LightWave-HQ/Hardware/1ED44175N01BXTSA1/1ED44175N01BXTSA1.stp

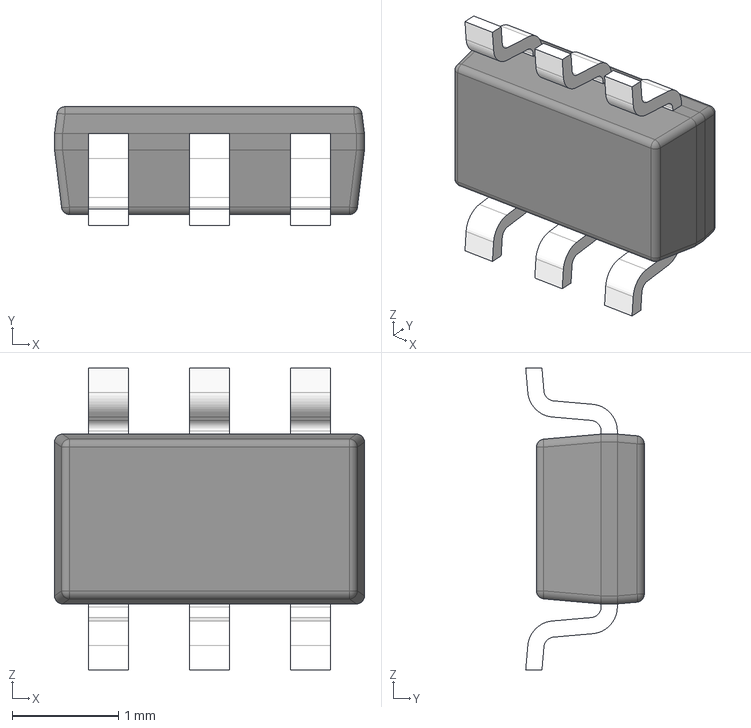
[picture p1: CAD file, 2024-12-27]
1ED44175N01BXTSA1/1ED44175N01BXTSA1.stp
2.92 x 1.12 x 2.84 mm
BODY_MF06A
LEAD_MF06A x 6
