LightWave-HQ/Hardware/SRN8040 Inductor/SRN8040-101M.STEP

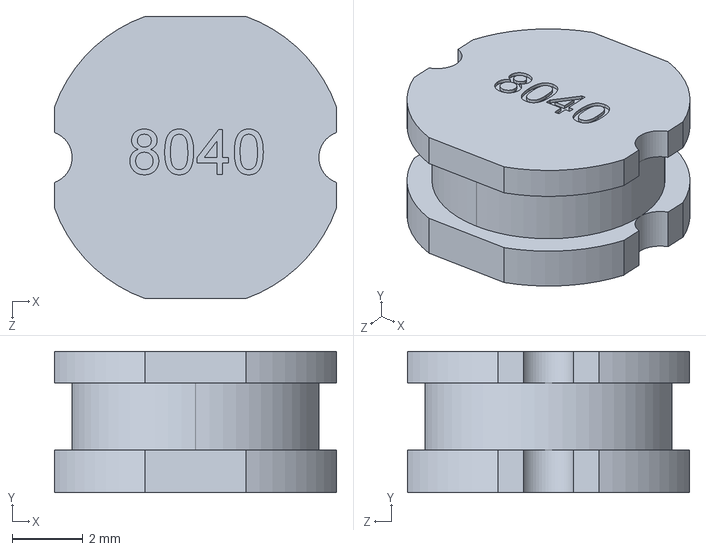
[picture p2: CAD file, 2025-01-21]
SRN8040 Inductor/SRN8040-101M.STEP
8.00 x 4.01 x 8.00 mm
