LightWave-HQ/Hardware/Led-Controller.kicad_pcb

## KiCad design Led-Controller.kicad_pcb (2025-02-26)

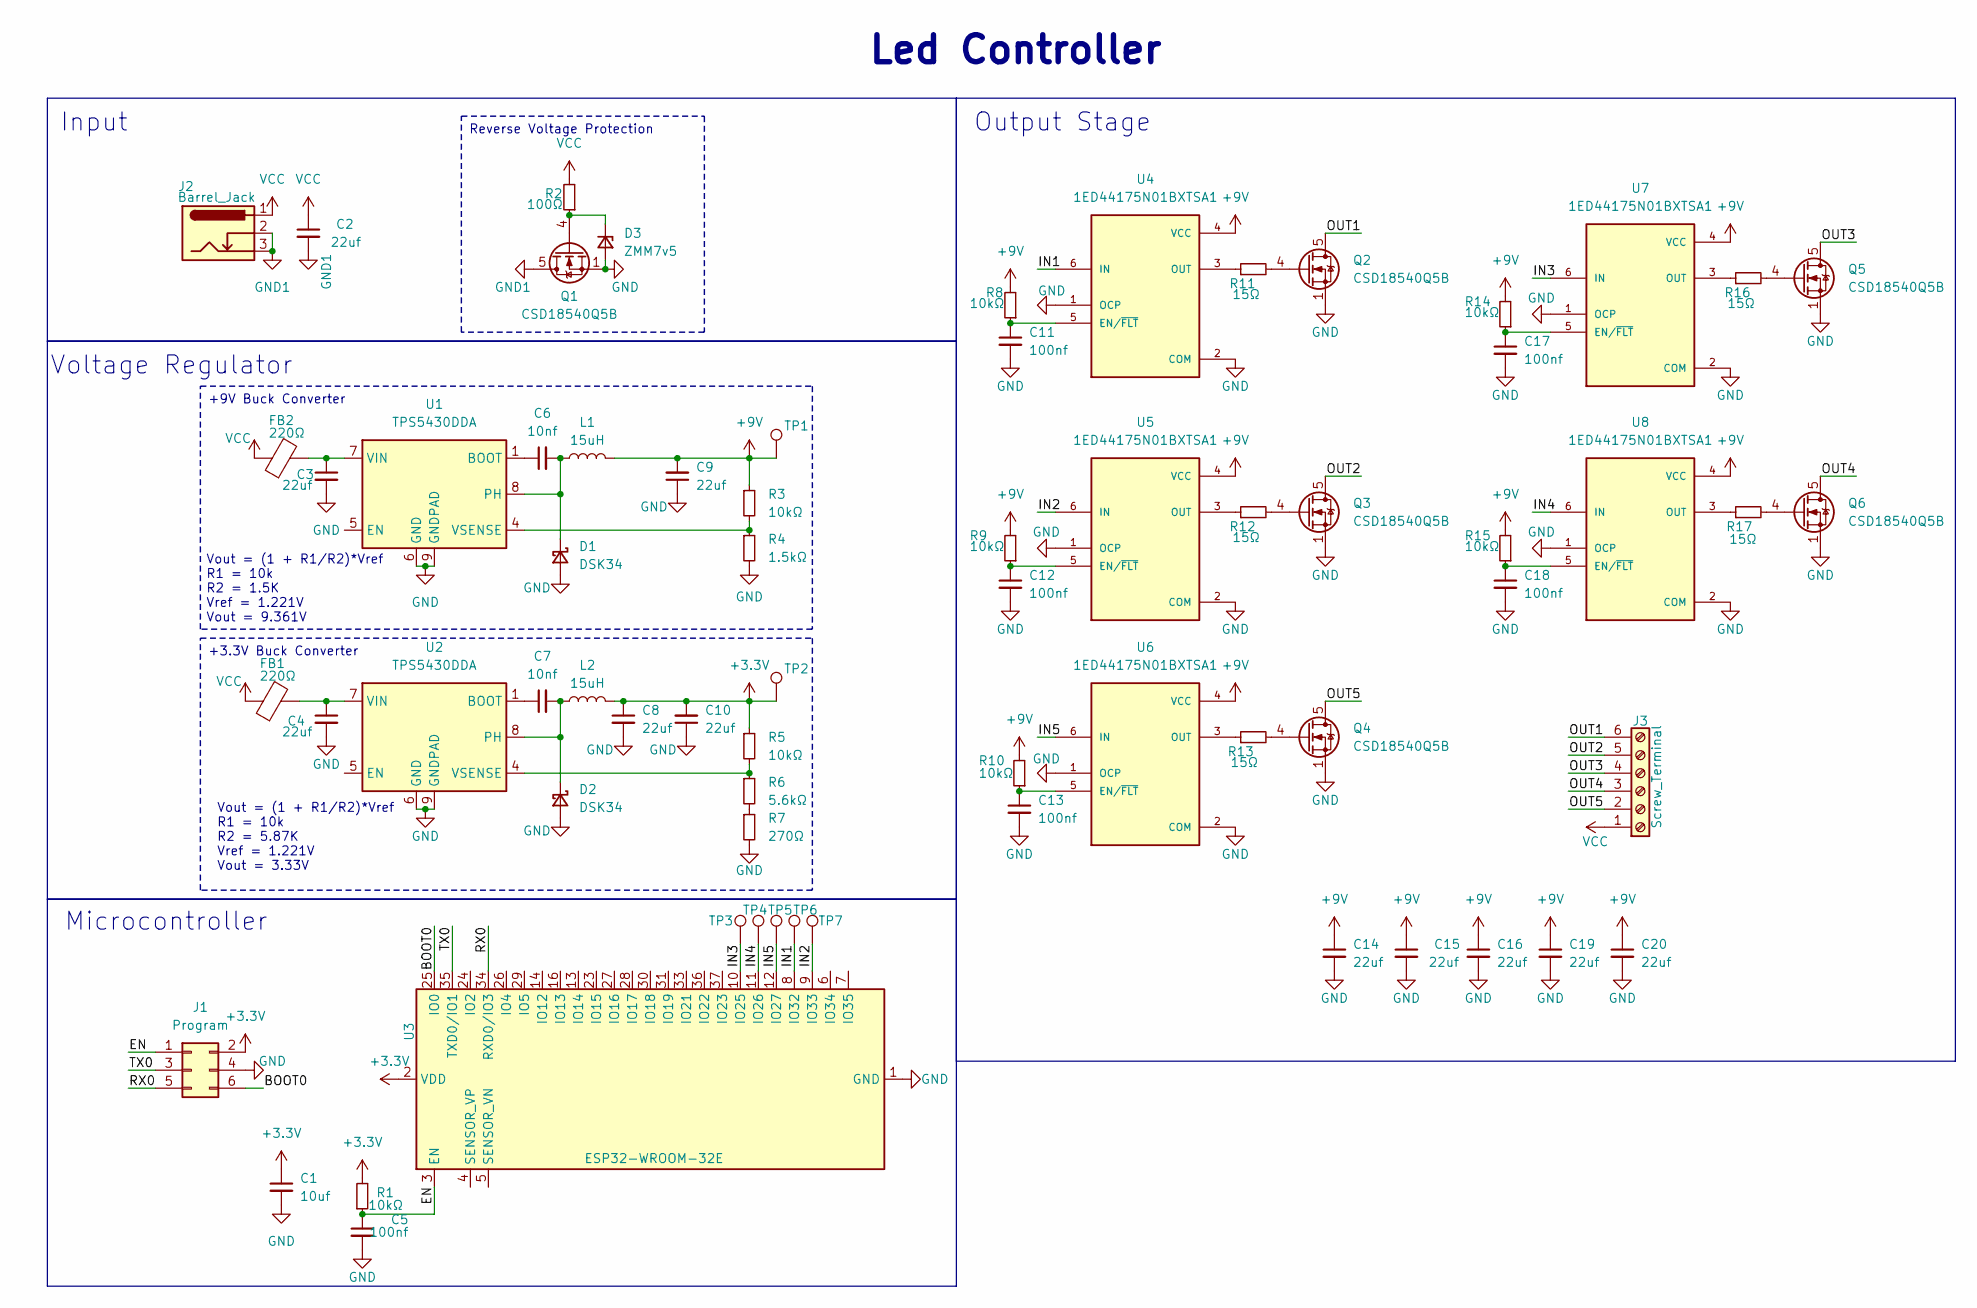
[picture p3: schematic Led-Controller.kicad_sch, LightWave]

Parts:
C1: 10uf; C_0402_1005Metric
C2, C3, C4, C8, C9, C10, C14, C15, C16, C19, C20: 22uf; C_0805_2012Metric
C5, C11, C12, C13, C17, C18: 100nf; C_0402_1005Metric
C6, C7: 10nf; C_0402_1005Metric
D1, D2: DSK34; D_SOD-123
D3: ZMM7v5; D_MiniMELF
FB1, FB2: 220Ω; R_0805_2012Metric
J1: Program; PinHeader_2x03_P1.27mm_Vertical
J2: Barrel_Jack; BarrelJack_GCT_DCJ200-10-A_Horizontal
J3: Screw_Terminal; TerminalBlock_bornier-6_P5.08mm
L1, L2: 15uH; L_Bourns-SRN8040_8x8.15mm
Q1, Q2, Q3, Q4, Q5, Q6: CSD18540Q5B; TDSON-8-1
R1, R3, R5, R8, R9, R10, R14, R15: 10kΩ; R_0402_1005Metric
R2: 100Ω; R_0402_1005Metric
R4: 1.5kΩ; R_0402_1005Metric
R6: 5.6kΩ; R_0402_1005Metric
R7: 270Ω; R_0402_1005Metric
R11, R12, R13, R16, R17: 15Ω; R_0402_1005Metric
TP1, TP2, TP3, TP4, TP5, TP6, TP7: TestPoint_Pad_D1.0mm
U1, U2: TPS5430DDA; TI_SO-PowerPAD-8_ThermalVias
U3: ESP32-WROOM-32E; ESP32-WROOM-32D
U4, U5, U6, U7, U8: 1ED44175N01BXTSA1; PARTREV 1.0

Connections:
+3.3V: C1.1, C8.1, C10.2, J1.2, L2.2, R1.2, R5.1, TP2.1, U3.2 (VDD)
+9V: C9.2, C14.1, C15.1, C16.1, C19.1, C20.1, L1.2, R3.1, R8.2, R9.2, R10.2, R14.2, R15.2, TP1.1, U4.4 (VCC), U5.4 (VCC), U6.4 (VCC), U7.4 (VCC), U8.4 (VCC)
/BOOT0: J1.6, U3.25 (IO0)
/EN: C5.1, J1.1, R1.1, U3.3 (EN)
/IN1: TP6.1, U3.8 (IO32), U4.6 (IN)
/IN2: TP7.1, U3.9 (IO33), U5.6 (IN)
/IN3: TP3.1, U3.10 (IO25), U7.6 (IN)
/IN4: TP4.1, U3.11 (IO26), U8.6 (IN)
/IN5: TP5.1, U3.12 (IO27), U6.6 (IN)
/OUT1: J3.6, Q2.5 (D)
/OUT2: J3.5, Q3.5 (D)
/OUT3: J3.4, Q5.5 (D)
/OUT4: J3.3, Q6.5 (D)
/OUT5: J3.2, Q4.5 (D)
/RX0: J1.5, U3.34 (RXD0/IO3)
/TX0: J1.3, U3.35 (TXD0/IO1)
GND: C1.2, C3.2, C4.2, C5.2, C8.2, C9.1, C10.1, C11.2, C12.2, C13.2, C14.2, C15.2, C16.2, C17.2, C18.2, C19.2, C20.2, D1.2 (A), D2.2 (A), D3.2 (A), J1.4, Q1.1 (S), Q1.2 (S), Q1.3 (S), Q2.1 (S), Q2.2 (S), Q2.3 (S), Q3.1 (S), Q3.2 (S), Q3.3 (S), Q4.1 (S), Q4.2 (S), Q4.3 (S), Q5.1 (S), Q5.2 (S), Q5.3 (S), Q6.1 (S), Q6.2 (S), Q6.3 (S), R4.2, R7.2, U1.6 (GND), U1.9 (GNDPAD), U2.6 (GND), U2.9 (GNDPAD), U3.1 (GND), U3.15 (GND), U3.38 (GND), U3.39 (GND), U4.1 (OCP), U4.2 (COM), U5.1 (OCP), U5.2 (COM), U6.1 (OCP), U6.2 (COM), U7.1 (OCP), U7.2 (COM), U8.1 (OCP), U8.2 (COM)
GND1: C2.2, J2.2, J2.3, Q1.5 (D)
unnamed: C6.2, D1.1 (K), L1.1, U1.8 (PH)
unnamed: C7.2, D2.1 (K), L2.1, U2.8 (PH)
unnamed: D3.1 (K), Q1.4 (G), R2.1
unnamed: Q2.4 (G), R11.2
unnamed: Q3.4 (G), R12.2
unnamed: Q4.4 (G), R13.2
unnamed: Q5.4 (G), R16.2
unnamed: Q6.4 (G), R17.2
unnamed: R6.2, R7.1
unnamed: C6.1, U1.1 (BOOT)
unnamed: C3.1, FB2.2, U1.7 (VIN)
unnamed: R3.2, R4.1, U1.4 (VSENSE)
unnamed: C7.1, U2.1 (BOOT)
unnamed: C4.1, FB1.2, U2.7 (VIN)
unnamed: R5.2, R6.1, U2.4 (VSENSE)
unnamed: C11.1, R8.1, U4.5 (EN/~FLT)
unnamed: R11.1, U4.3 (OUT)
unnamed: C12.1, R9.1, U5.5 (EN/~FLT)
unnamed: R12.1, U5.3 (OUT)
unnamed: C13.1, R10.1, U6.5 (EN/~FLT)
unnamed: R13.1, U6.3 (OUT)
unnamed: C17.1, R14.1, U7.5 (EN/~FLT)
unnamed: R16.1, U7.3 (OUT)
unnamed: C18.1, R15.1, U8.5 (EN/~FLT)
unnamed: R17.1, U8.3 (OUT)
VCC: C2.1, FB1.1, FB2.1, J2.1, J3.1, R2.2

Notes on the sheet:
Reverse Voltage Protection
+9V Buck Converter
+3.3V Buck Converter
Input
Vout = (1 + R1/R2)*Vref R1 = 10k R2 = 1.5K Vref = 1.221V Vout = 9.361V
Voltage Regulator
Output Stage
Microcontroller
Vout = (1 + R1/R2)*Vref R1 = 10k R2 = 5.87K Vref = 1.221V Vout = 3.33V
Led Controller

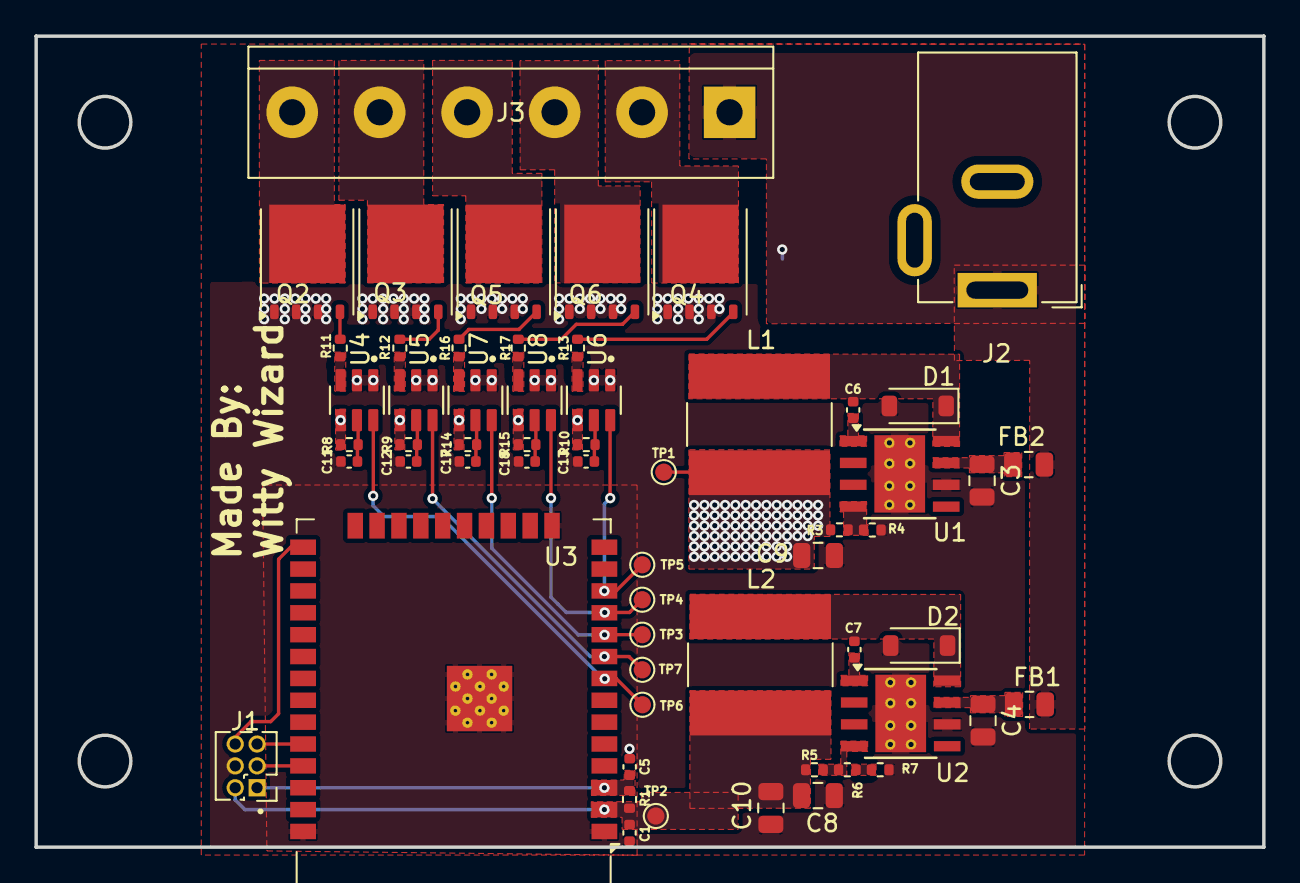
[picture p4: board Led-Controller.kicad_pcb from above]

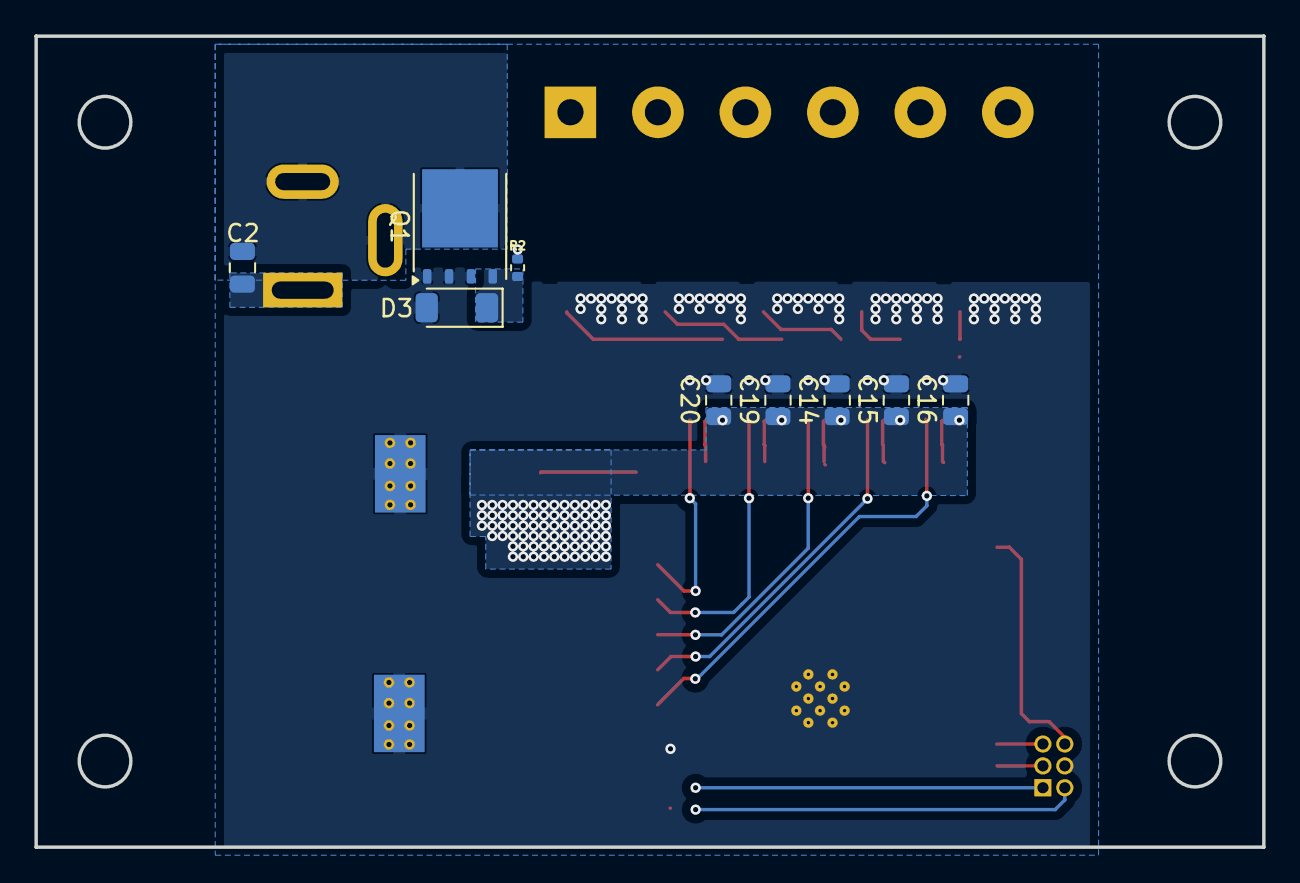
[picture p5: board Led-Controller.kicad_pcb from below]

Board: 2 copper layers, 71.3 x 47.1 mm, 68 parts (9 on the bottom side), 44 nets.
