LightWave-HQ/Hardware/(threads)

Thread 1 (2025-01-17):

Prototype Version 1 Flaws

Witty-Wizard, 2025-01-17:
# Introduction
This Issue discusses the design flaws in the first iteration of the PCB design, and fixes for it, below is the image of the manufactured PCB.
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

## Flaws
### 1. Pin 14 on the ESP32 is reserved
- Pin 14 is reserved for the internal flash and should not be used
- WLED firmware does not allow the use of Pin 14

### 2. Pull up resistor missing
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
- The missing pull up resistor for the EN pin causes the ESP32 to not boot

### 3. R8 and R10 are not connected to the respective Gate driver
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
- The Gate resistors R8 and R10 are not connected to their respective Gate drivers

### 4. Narrow VCC Path
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
- Very narrow Path for the VCC connection to the MOSFETS, resulting in Higher resistance (Good enough for currents up to 3-4A but not a good practice)

### 5. MOSFET Choice
- The currently used P channel MOSFET is not Ideal due to its High resistance and higher Price
- Change them with N channel MOSFETS

### 6. U5 Soft start resistor unconnected
- The U5 Driver soft start circuitry has not been connected to the gate driver
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

### 7. Use smaller Passive components
- Gate resistors, soft start RC circuit, and the decoupling capacitors can be replaced with smaller footprints like 603 or 402 footprints

### 8. Use a Switching Converter for Auxiliary Power
- Use a Switching Regulator to convert directly to 3.3V
- Add another switching regulator to convert VCC to 9V. This allows for constant voltage to the gate driver enabling the circuit to support voltages up to 24V.

### 9. Programming Pins
- Add a 6Pin IDC header so that esp32 can be programmed while soldered on the PCB

### 10. ESD Protection
- Add ESD Protection to the Output of the Microcontroller
- Add ESD protection to the DC jack input of the circuit

### 11. Reverse voltage protection
- Add a Reverse Voltage protection of some kind on the input of the Circuit

### 12. Fuse
- Add a fuse on the input of the circuit

### 13. Limit inrush current
- When the Circuit is plugged in for the first time, it pulls a lot of current from the power supply.
- Add an inrush current protection, either using NTC or using active solution, using MOSFET.

Witty-Wizard, 2025-01-22:
## Final PCB Layout
The above issues have been solved and new enhancements have been made to the design. I have also made the final board layout, now to do the Board routing and then `v0.0.2` of the PCB will be ready

Closed 2025-01-22.

Thread 10 (2025-01-17):

Add a programming Header

Witty-Wizard, 2025-01-17:
## Overview
There is no way to program the microcontroller once soldered to the PCB.

## Solution
Add a 6pin IDC connector to the board so that the microcontroller can be programmed using ESP-PROG

Closed 2025-01-18.

Thread 11 (2025-01-17):

Add ESD protection

Witty-Wizard, 2025-01-17:
## Overview
- Add TVS Diode for ESD protection on the output of the PWM signal pin.
- Add Zener Diode on the Gate for over-voltage protection.
- Add Zener Diode on the 3.3V line to prevent voltage spikes on the Microcontroller power supply

Thread 12 (2025-01-17):

Reverse Voltage Protection

Witty-Wizard, 2025-01-17:
## Overview
In the current Setup if the user were to apply reverse polarity to the circuit it would go KABOOM!!! To prevent such disasters from happening, it is better to add a reverse voltage protection circuit using a simple N channel MOSFET.

- Add MOSFET for reverse Voltage protection
- Add Zener on gate of MOSFET to protect the MOSFET

Closed 2025-01-18.

Thread 2 (2025-01-17):

Change Pin14

Witty-Wizard, 2025-01-17:
## Overview
Pin 14 on the ESP32 Wroom board is reserved pin and can not be configured as output.

## Solution
Change the ESP32 pin to some other pin that is not reserved for internal functions.

Witty-Wizard, 2025-01-17:
## Reserved for JTAG
According to the [ESP32 Documentation](https://docs.espressif.com/projects/esp-idf/en/stable/esp32/api-guides/jtag-debugging/configure-ft2232h-jtag.html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) the pins 12,13,14,15 are for JTAG and are not recommended to be used for output as they require specific voltage levels during boot.

Closed 2025-01-17.

Thread 3 (2025-01-17):

EN Pin Pull up resistor

Witty-Wizard, 2025-01-17:
## Overview
In the Prototype PCB #1, the EN pin is not connected to the 3.3V voltage line, due to which the capacitor never charges and the EN pin never reaches 3.3V level.
For the microcontroller to boot the EN pin should be HIGH.

## Solution
Add a pull up resistor of around 10kΩ to 3.3V

Thread 4 (2025-01-17):

Missing PCB trace

Witty-Wizard, 2025-01-17:
## Overview
The prototype PCB has the output of Gate driver U4, U5 floating, it should be connected to R9 and R10. The resistor are placed on the PCB but the Track is missing.

Closed 2025-01-17.

Thread 5 (2025-01-17):

High Resistance MOSFET Connection

Witty-Wizard, 2025-01-17:
## Overview
The Copper plane connecting the MOSFET to the VCC rail are very narrow, they can not handle much current and need to be thicker.

Witty-Wizard, 2025-01-17:
This issue closed with #6, as that PR changed the MOSFET from P channel to N channel

Closed 2025-01-17.

Thread 6 (2025-01-17):

Change MOSFET

Witty-Wizard, 2025-01-17:
## Overview
The current design uses P channel MOSFET, those have significant disadvantages-
- Difficult to drive
- Higher Resistance
- Higher Cost

## Solution
Solution is to replace them with similar N channel MOSFETS.

Closed 2025-01-17.

Thread 7 (2025-01-17):

Missing PCB Trace

Witty-Wizard, 2025-01-17:
## Overview
The RC circuit for soft starting the U5 Gate driver is present on the PCB but not connected to the gate driver, this needs to be fixed in the design

Closed 2025-01-17.

Thread 8 (2025-01-17):

Use smaller Passive components

Witty-Wizard, 2025-01-17:
## Overview
The current design uses 805 package for most of the passive components, which increase the size of the PCB.

## Solution
- Replace the Passive component to smaller packages like 0402 or 603 package.

Closed 2025-01-17.

Thread 9 (2025-01-17):

Use Switching converter for Auxiliary power

Witty-Wizard, 2025-01-17:
## Overview
The current design uses linear converter for auxiliary power circuit. The Auxiliary power circuit provides power to the microcontroller. There are several disadvantages of the current setup-
- 12V only Input: The gate driver is currently powered directly from the DC Supply line, due to this the input voltage is limited to 12V, going above 12V will cause the linear regulators to heat up and also the Gate of MOSFET breaks down at 20V, so any voltage above 20V will destroy the whole circuit.
- Inefficient: The current linear regulator is convenient and inexpensive, but it is very inefficient as it waste energy as heat.

## Solution
- Use a Switching regulator to generate the required Voltages for the microcontroller and the Gate drivers

Closed 2025-01-21.

Thread 22 (2025-01-21):

input ripple creates a beat frequency

Witty-Wizard, 2025-01-21:
## Overview
When two asynchronous switchers run in parallel (i.e from the same input) they can cause a input ripple that creates a "beat frequency." Which can eventually cause the converters to go unstable (or allow significant ripple to pass to their output.)

Closed 2025-01-21.
