LightWave-HQ/Hardware/(commit log)

2024-12-27 Hardware with Mosfets
    [1ED44175N01BXTSA1.stp, BSZ180P03.step, Led-Controller.kicad_pcb, Led-Controller.kicad_sch]
2025-01-17 Fixed: Pin assignment
    [Led-Controller.kicad_pcb, Led-Controller.kicad_sch]
2025-01-17 Added: Pull up resistor for EN pin
    [Led-Controller.kicad_pcb, Led-Controller.kicad_sch]
2025-01-17 Added: the missing trace connecting Driver to MOSFET
    [Led-Controller.kicad_pcb]
2025-01-17 Added: N channel mosfet in place of P channel mosfet (#16)
    [BSZ180P03.step, Led-Controller.kicad_pcb, Led-Controller.kicad_sch]
2025-01-17 Fixed: Missing trace of RC circuit connecting to the gate driver (#17)
    [Led-Controller.kicad_pcb]
2025-01-17 Changed Components to smaller Footprint (#18)
    [Led-Controller.kicad_pcb, Led-Controller.kicad_sch]
2025-01-18 Added: Reverse voltage protection (#19)
    [Led-Controller.kicad_pcb, Led-Controller.kicad_sch]
2025-01-18 Added: 6 Pin IDC Connector for Programming (#20)
    [Led-Controller.kicad_pcb, Led-Controller.kicad_sch]
2025-01-21 Added: Switching Regulator (#21)
    * Added: Switching Regulator Schematic
    * Added: Final Layout for the Switching regulator along with the overall PCB layout
    [Led-Controller.kicad_pcb, Led-Controller.kicad_sch, SRN8040-101M.STEP]
2025-01-21 Added: Ferrite bead for conduction EMI filtering (#23)
    [Led-Controller.kicad_pcb, Led-Controller.kicad_sch]
2025-01-22 Final Layout of alpha version 2 (#24)
    * Did basic routing for voltage regulators
    * Final Layout of PCB version 2 alpha
    [Led-Controller.kicad_pcb, Led-Controller.kicad_sch]
2025-02-26 Added: New Outline file
    [Led-Controller.kicad_pcb]
2025-03-09 Fixed: Build Pipeline
    Updated: Kicad version from v8.0.0 to v9.0.0
